fpozzana/Par.Ma/README.md

# Par.Ma


Par.Ma is a 2.5 particulate matter measurement system.

PCB designed for the Electronic systems engineering course at Politecnico di Torino. For further informations on the PCB design refer to the report in the *report* folder.

## Tools

For this project the following tools were used
- OrCAD Capture CIS
- Allegro PCB editor
