fpozzana/Par.Ma/Report/Report.pdf

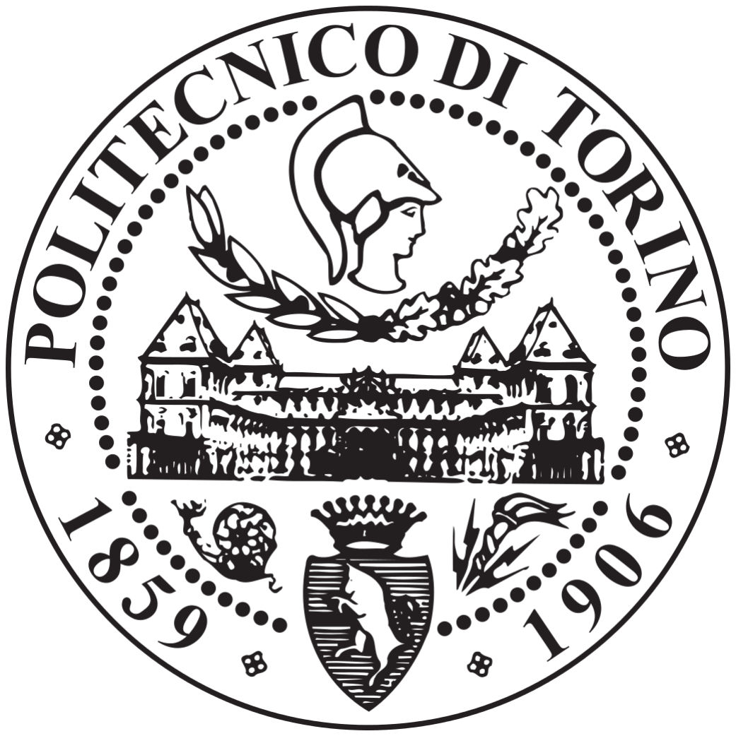
[picture p1: figure]

# Politecnico di Torino

# Electronic systems engineering

# PARticulate MAtter monitoring system

## Technical report

Federico Pozzana, 254758
Professor Eros Pasero

January 12, 2020

## Contents

0 Project specifications | 2
1 Design flow | 2
2 Component selection | 4
3 Schematics | 17
4 Allegro | 22
5 Conclusion | 22

## 0 Project specifications

The PAR.MA. (PARticulate MAtter monitoing system) is a smart particulate matter sensor to measure the concentration of PM2.5 in the environment where it is placed and to report the measurement thanks to the bluetooth technology.
The main specifications of the system are
- PM2.5 accuracy : 10 ug/m3
- Operating temperature : -10 C to 50 C
- Portable form factor
- Rechargeable battery

The main application for this system is to measure the PM2.5 concentration of an open air environment (e.g. main street of a city center), however it can be used inside a home as well. The system is made up of four main blocks, namely

- Power supply : this block is dedicated to the power distribution of the system and the recharge process
- Microprocessor : this block is dedicated to the computational unit of the system; it reads the data coming from the sensor and start the bluetooth communication
- PM2.5 sensor : this block is dedicated to the sensing of the PM2.5 concentration; the communication with the microprocessor is achieved thanks to the UART protocol
- RF module : this block is dedicated to control the PCB antenna

The entire block diagram is shown in the following figure.

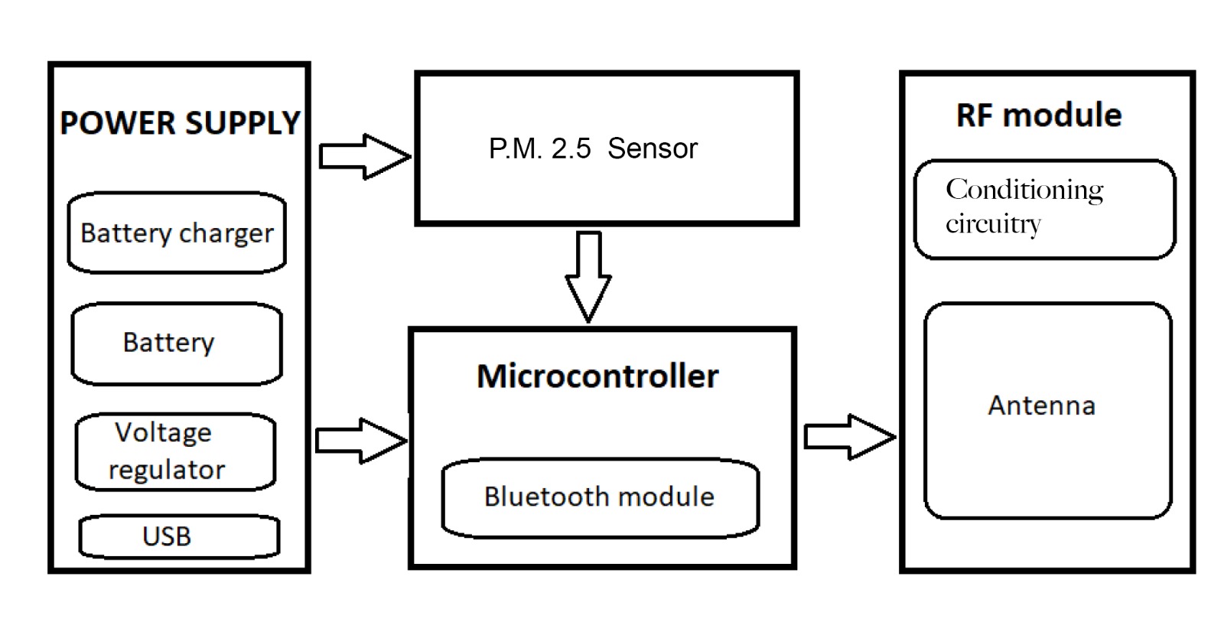
[picture p2: figure]

## 1 Design flow

The design and development of the project followed the step in the table below.

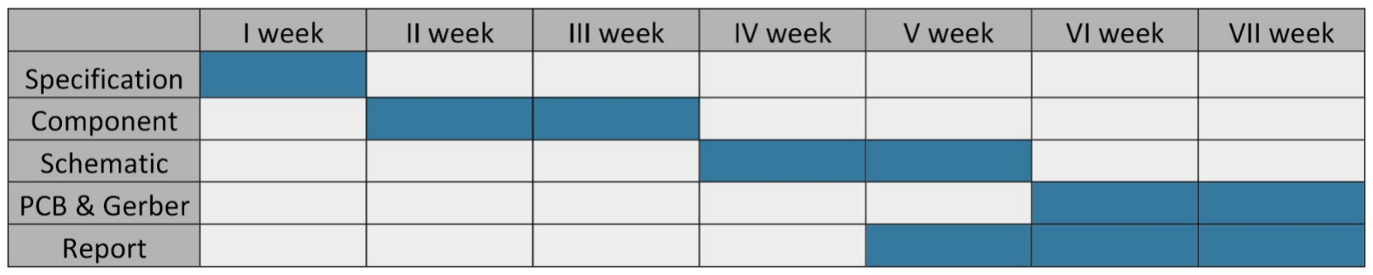
[picture p3: figure]

The following steps were followed in order to complete the system design

- At first the system specifications were defined, the choices in this stage influenced the whole design and the following steps.

- Then the components for the design were chosen according to the initial specifications.
- The schematics were created on ORCAD Capture connecting the components selected in the previous step.
- The PCB was designed according to the manufacturer constraints, the final gerber files were sent to the manufacturer for further checks.
- The technical report was written in order to explain the choices for the system design.

## 2 Component selection

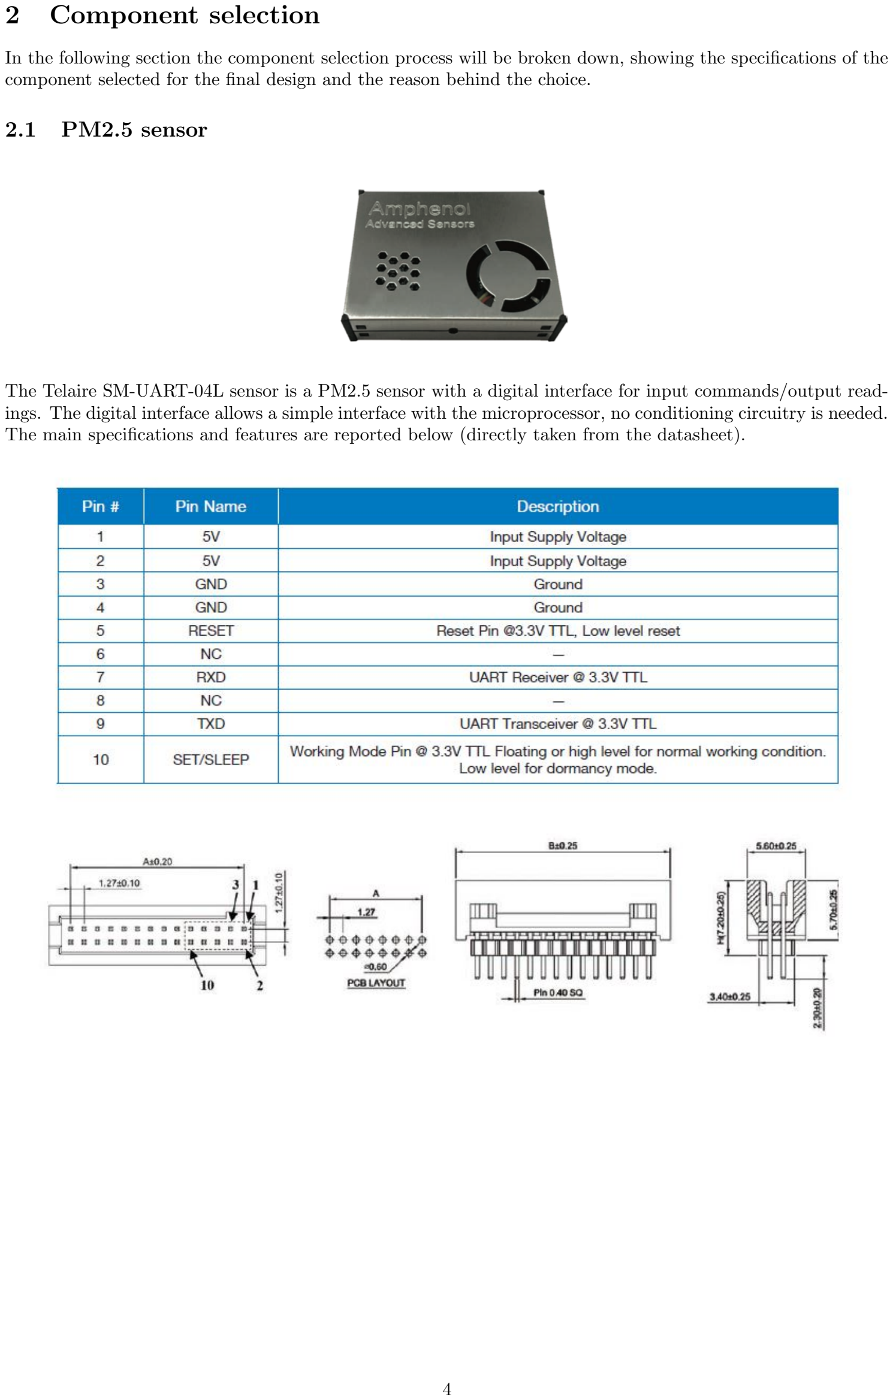
[picture p4: page 5]

In the following section the component selection process will be broken down, showing the specifications of the component selected for the final design and the reason behind the choice.

### 2.1 PM2.5 sensor

The Telaire SM-UART-04L sensor is a PM2.5 sensor with a digital interface for input commands/output read-ings. The digital interface allows a simple interface with the microprocessor, no conditioning circuitry is needed. The main specifications and features are reported below (directly taken from the datasheet).

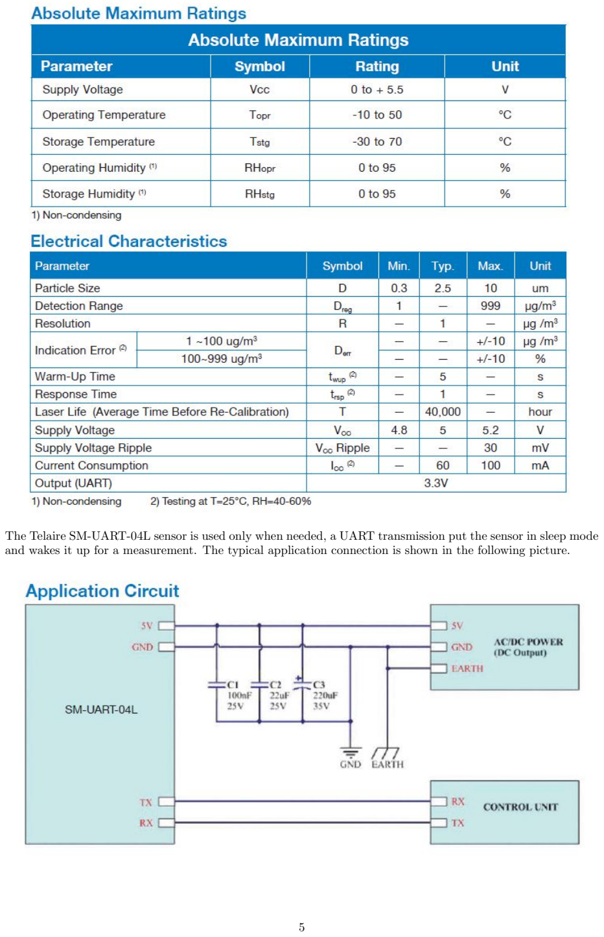
[picture p5: page 6]

The Telaire SM-UART-04L sensor is used only when needed, a UART transmission put the sensor in sleep mode and wakes it up for a measurement. The typical application connection is shown in the following picture.

### 2.2 Microcontroller

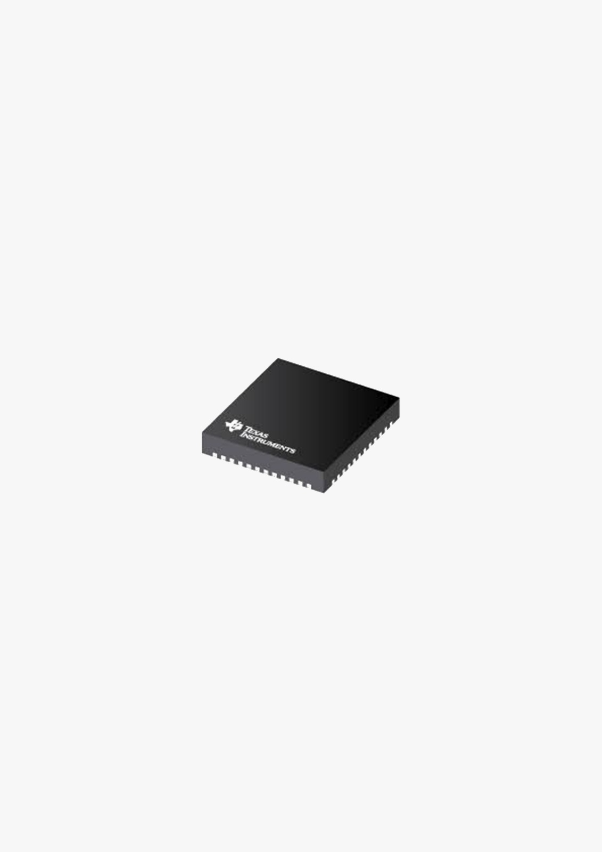
[picture p6: figure]

The choice for the microcontroller unit (MCU) to be used in the project is a fixed requirement; the MCU used is the CC2640R2F from TI. This particular MCU offers both 4.1 and 5.0 Bluetooth connectivity for low energy applications. This particular MCU have a 32-bit ARM Cortex-M3 core, up to 128 Kbytes of flash memory, up to 20 kbytes of SRAM and supports I2C, UART and many more common interfaces. A functional diagram of the MCU is as follows

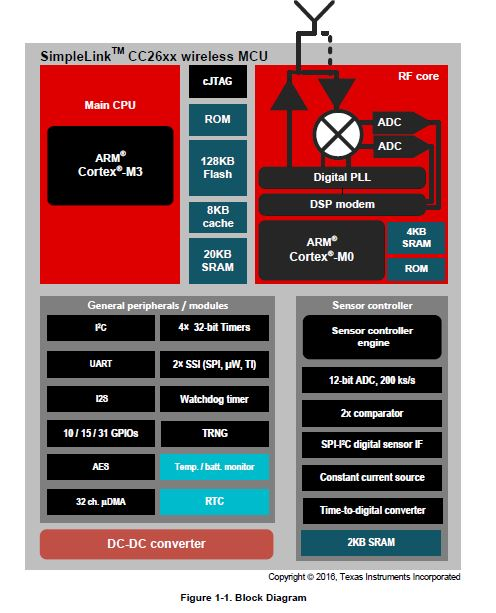
[picture p7: figure]

This MCU is available in different packages, my choice was to employ the 7x7 mm VQFN 48 pins RGZ package for ease of use in case of potentially building the circuit at a different time. The electrical characteristics of the MCU are as follows

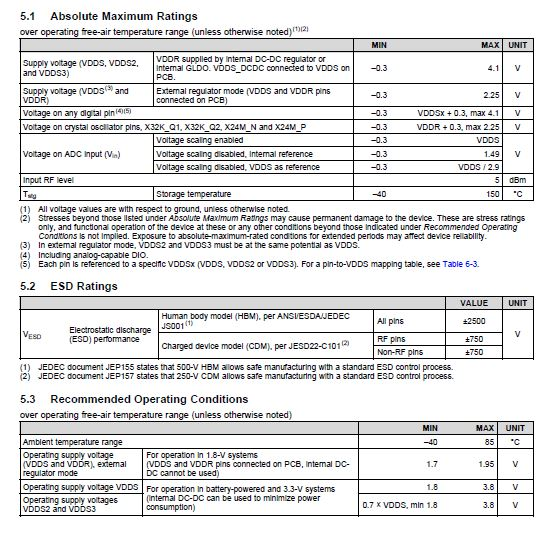
[picture p8: figure]
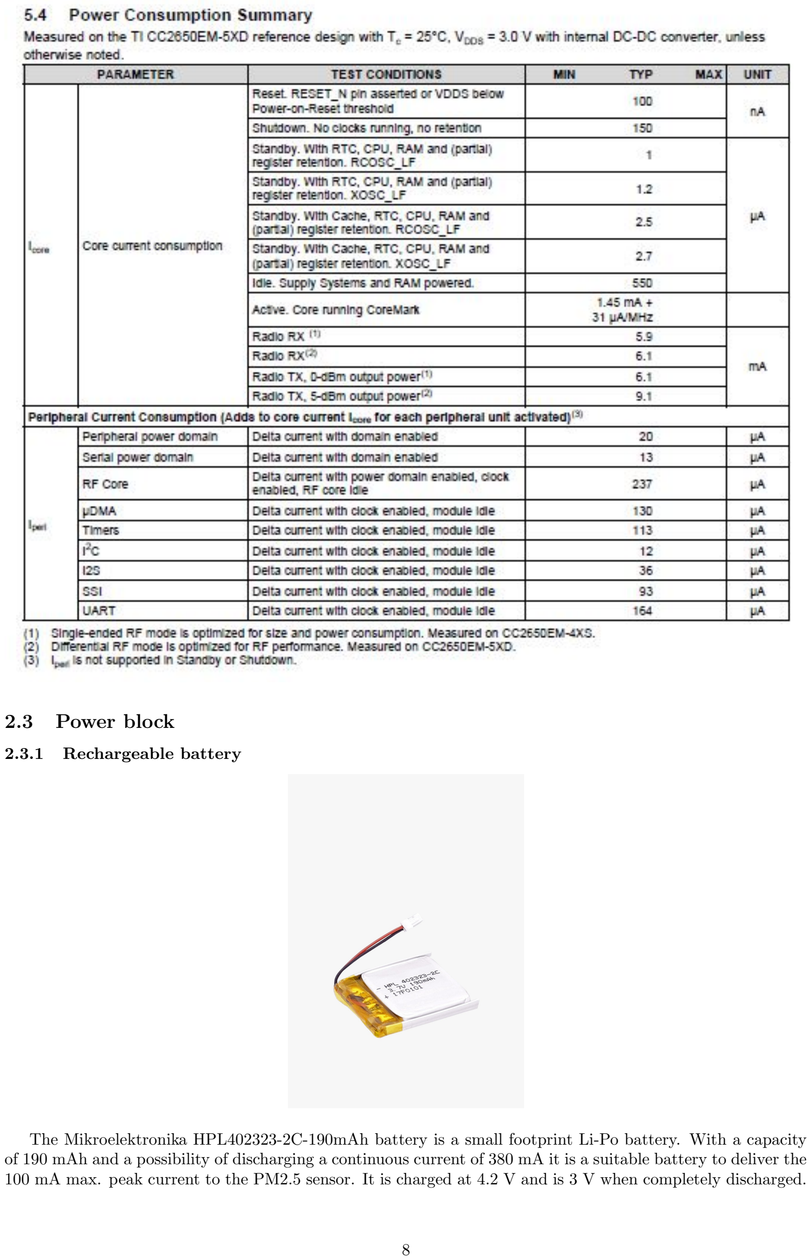
[picture p9: page 9]

### 2.3 Power block

### 2.3.1 Rechargeable battery

The Mikroelektronika HPL402323-2C-190mAh battery is a small footprint Li-Po battery. With a capacity of 190 mAh and a possibility of discharging a continuous current of 380 mA it is a suitable battery to deliver the 100 mA max. peak current to the PM2.5 sensor. It is charged at 4.2 V and is 3 V when completely discharged.

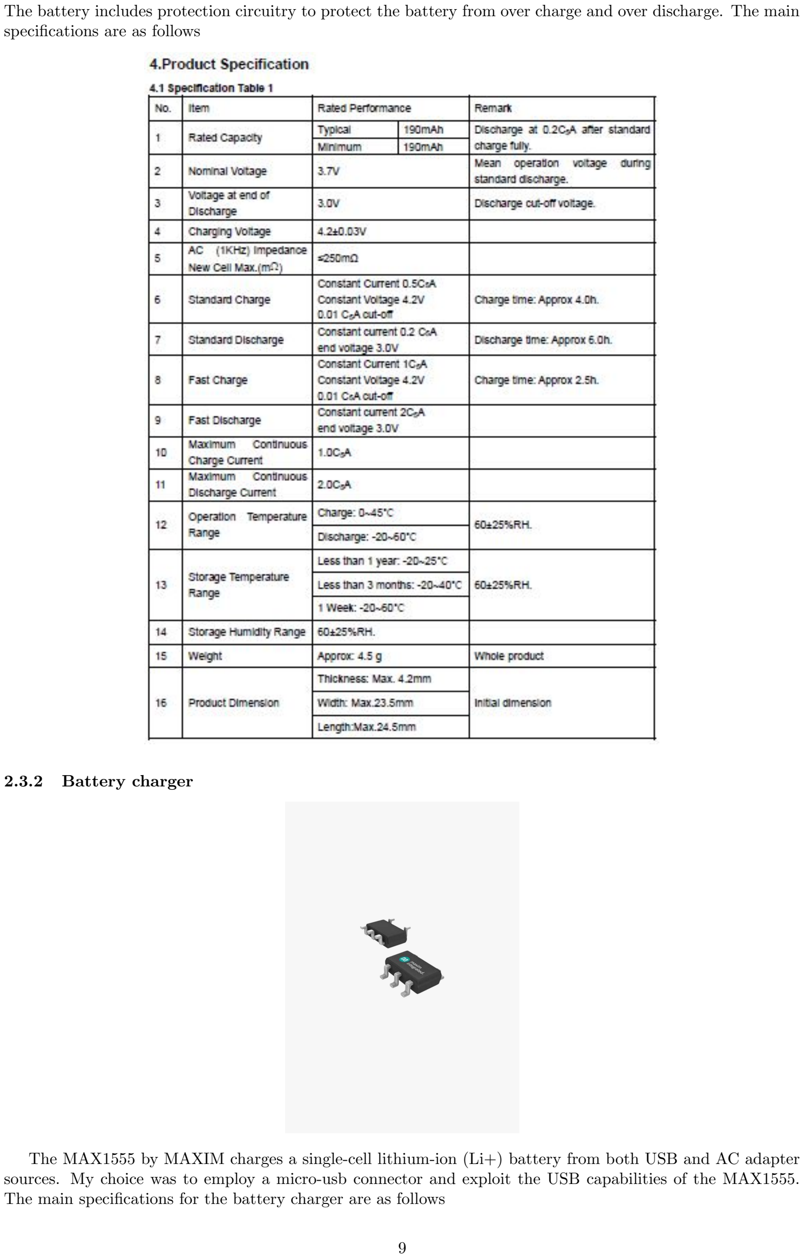
[picture p10: page 10]

The battery includes protection circuitry to protect the battery from over charge and over discharge. The main specifications are as follows

### 2.3.2 Battery charger

The MAX1555 by MAXIM charges a single-cell lithium-ion (Li+) battery from both USB and AC adapter sources. My choice was to employ a micro-usb connector and exploit the USB capabilities of the MAX1555. The main specifications for the battery charger are as follows

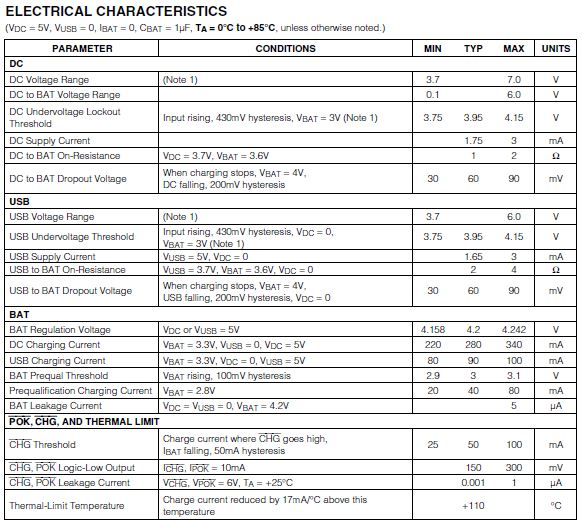
[picture p11: figure]
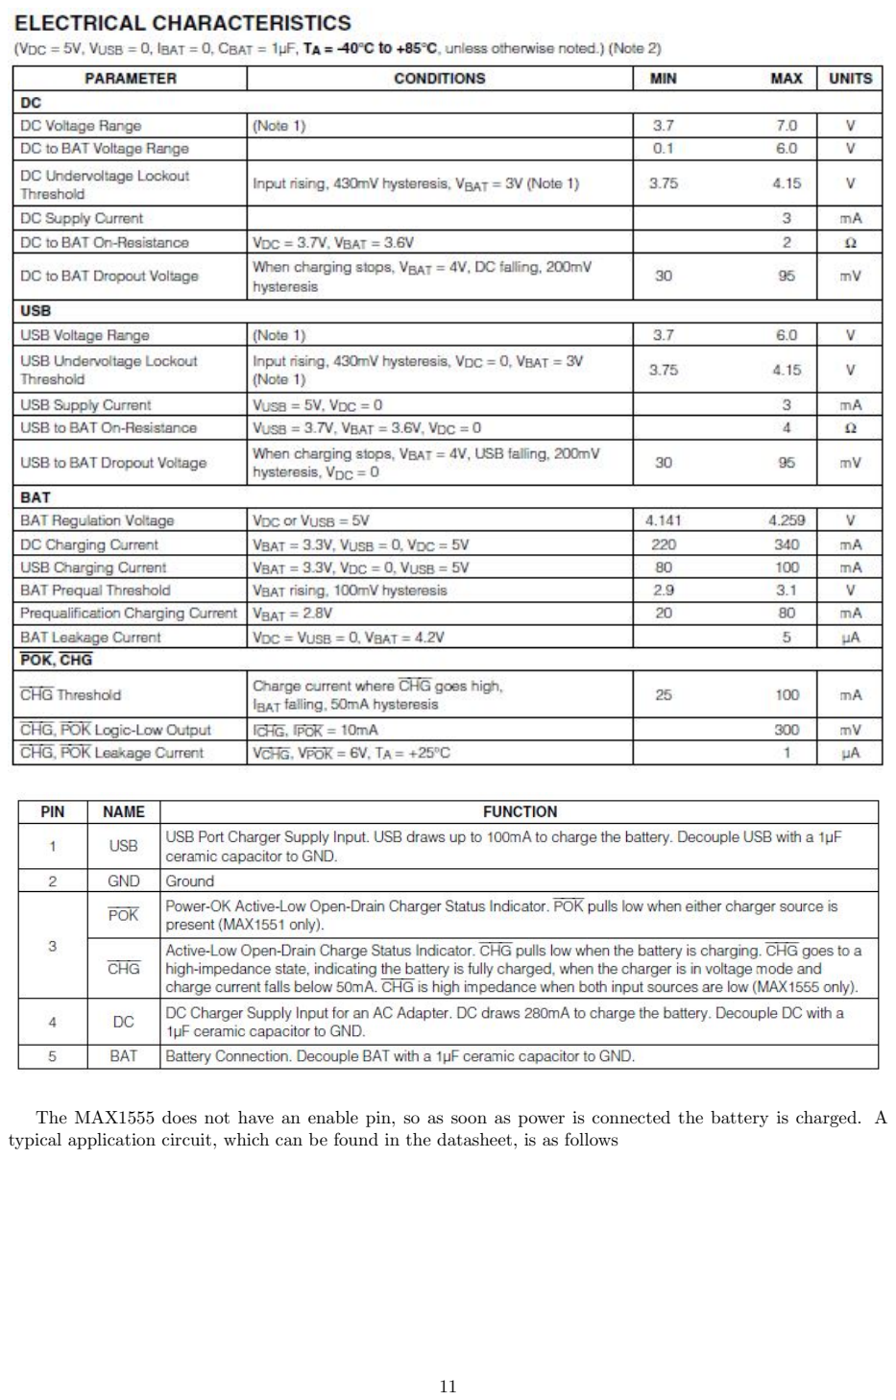
[picture p12: page 12]

The MAX1555 does not have an enable pin, so as soon as power is connected the battery is charged. A typical application circuit, which can be found in the datasheet, is as follows

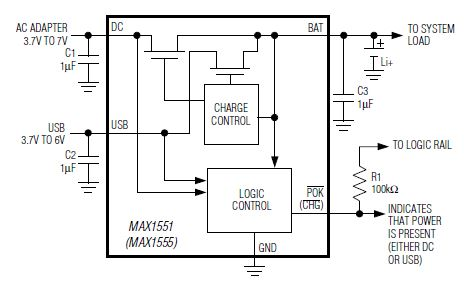
[picture p13: figure]

### 2.3.3 Voltage regulator

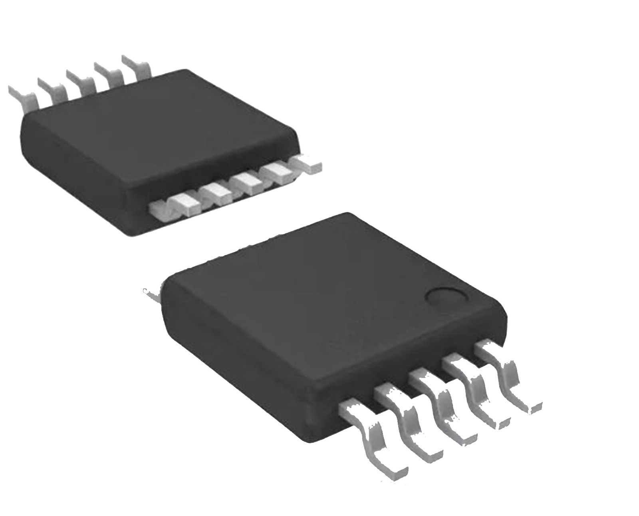
[picture p14: figure]

The MAX1759 by MAXIM is a buck/boost regulating charge pump that generates a regulated output voltage from a single lithium-ion (Li+) cell. The main features for the voltage regulator are as follows

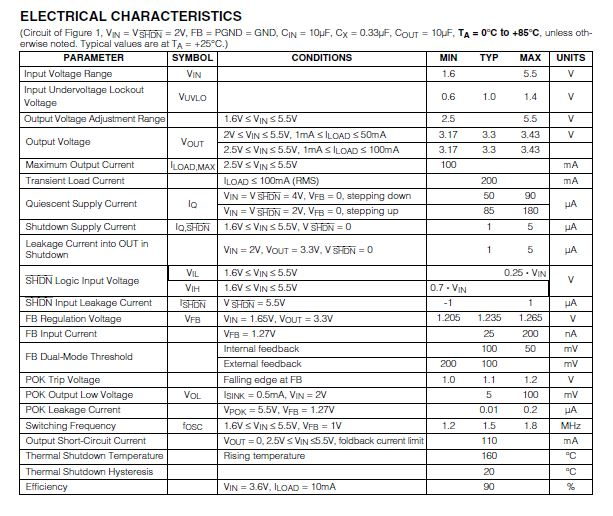
[picture p15: figure]
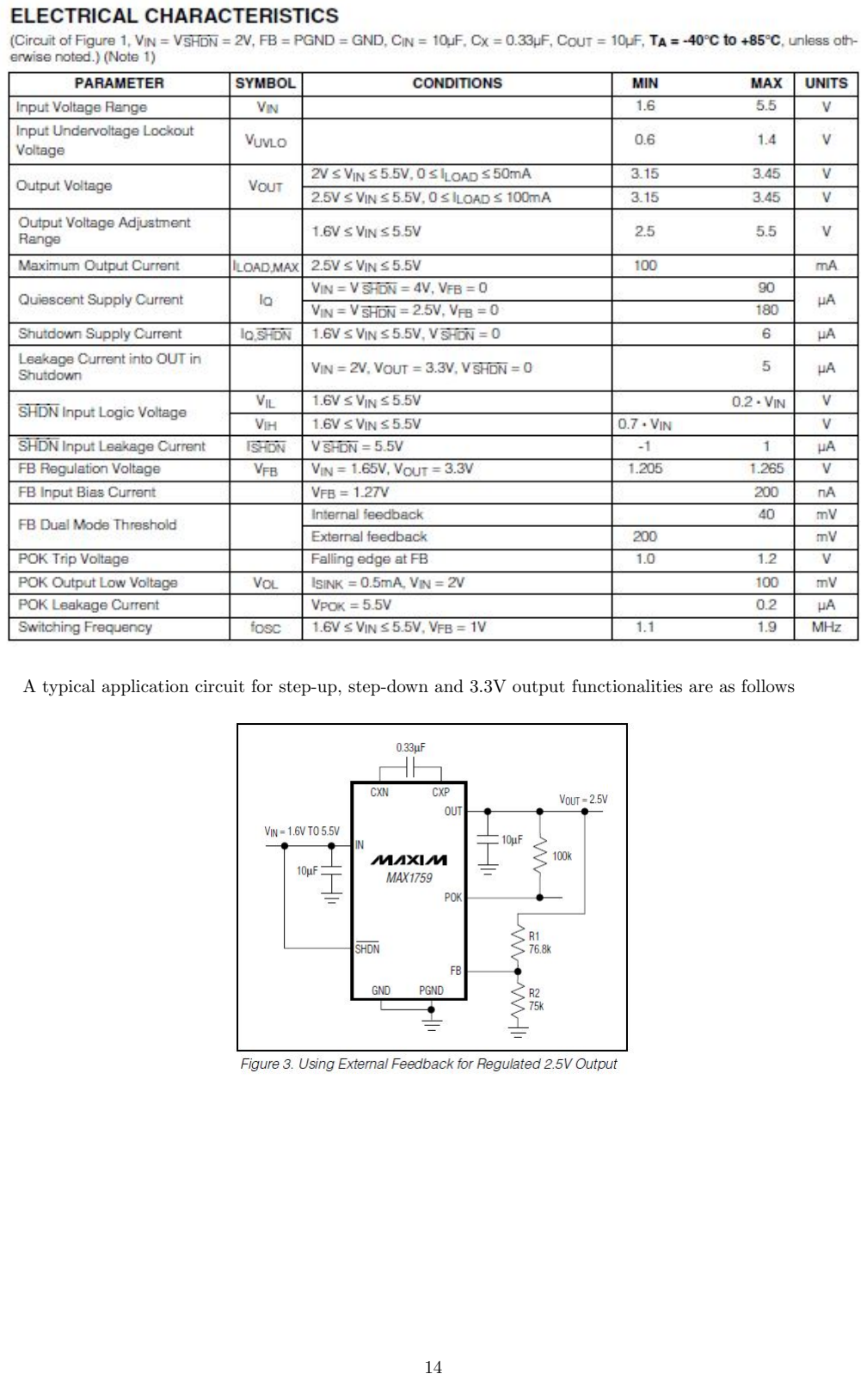
[picture p16: page 15]

A typical application circuit for step-up, step-down and 3.3V output functionalities are as follows

### 2.4 Switch

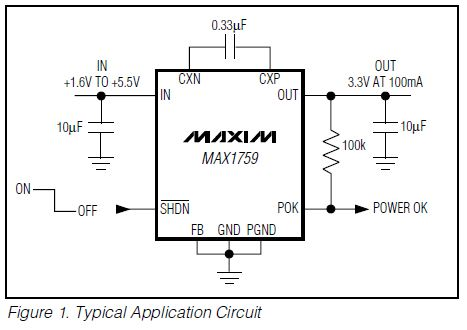
[picture p17: figure]
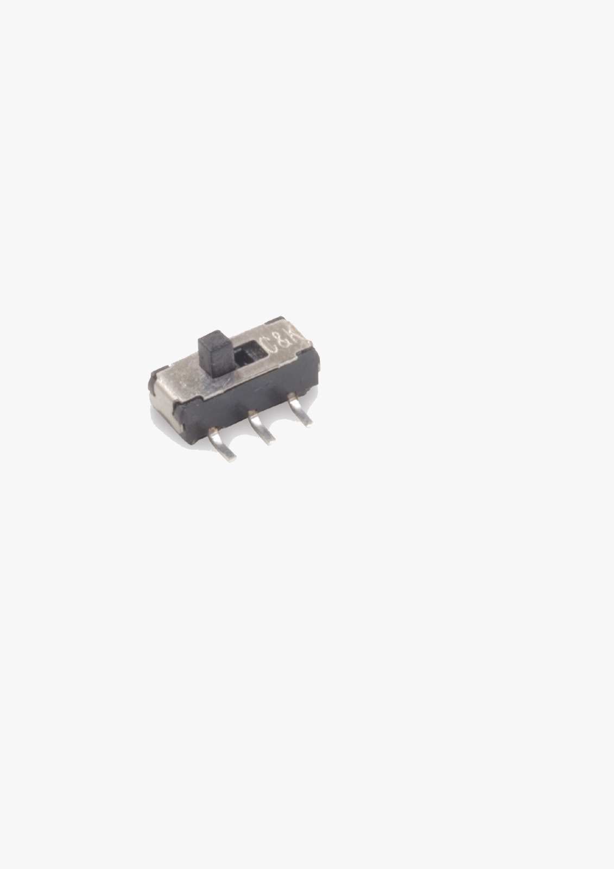
[picture p18: figure]

The JS202011SCQN-DPDT switch has been used. The switch is used to cut off the Li-Po battery from the circuit. The main specifications for the JS202011SCQN-DPDT switch are as follows

### 2.5 LED

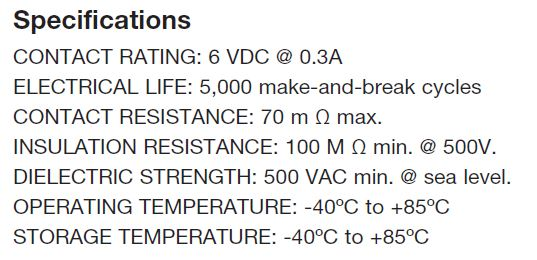
[picture p19: figure]
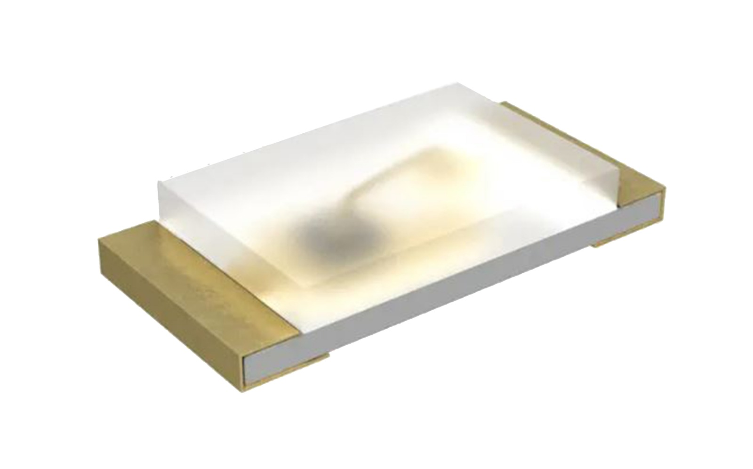
[picture p20: figure]

The APG1608ZGC from Kingbright LED’s are used for the design. Typical applications for this component are status indicator, backlight and wearable and portable devices as stated in the datasheet. The main characteristics for this component are as follows

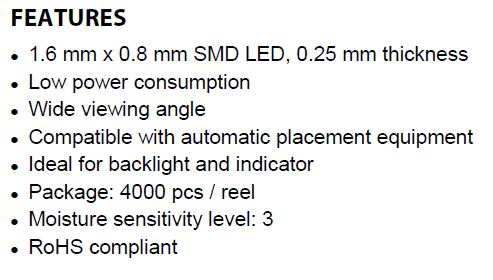
[picture p21: figure]

## 3 Schematics

The schematics for this project are designed using ORCAD Capture. It is possible to identify four possible sections for the PAR.MA. project

- Microcontroller
- Peripherals
- Power
- RF

JTAG_TCKC 25 DIO_16 26 DIO_17 27 DIO_18 28 DIO_19 29 DIO_20 30 DIO_21 31 DIO_22 32 DCDC_SW | 33 VDDS_DCDC | 34 RESET_N | 35 DIO_23 36 DIO_24 37 DIO_25 38 DIO_26 39 DIO_27 40 DIO_28 41 DIO_29 42 DIO_30 43 VDDS 44 VDDR 45 X24M_N 46 X24M_P 47 VDDR_RF 48 EPAD 49

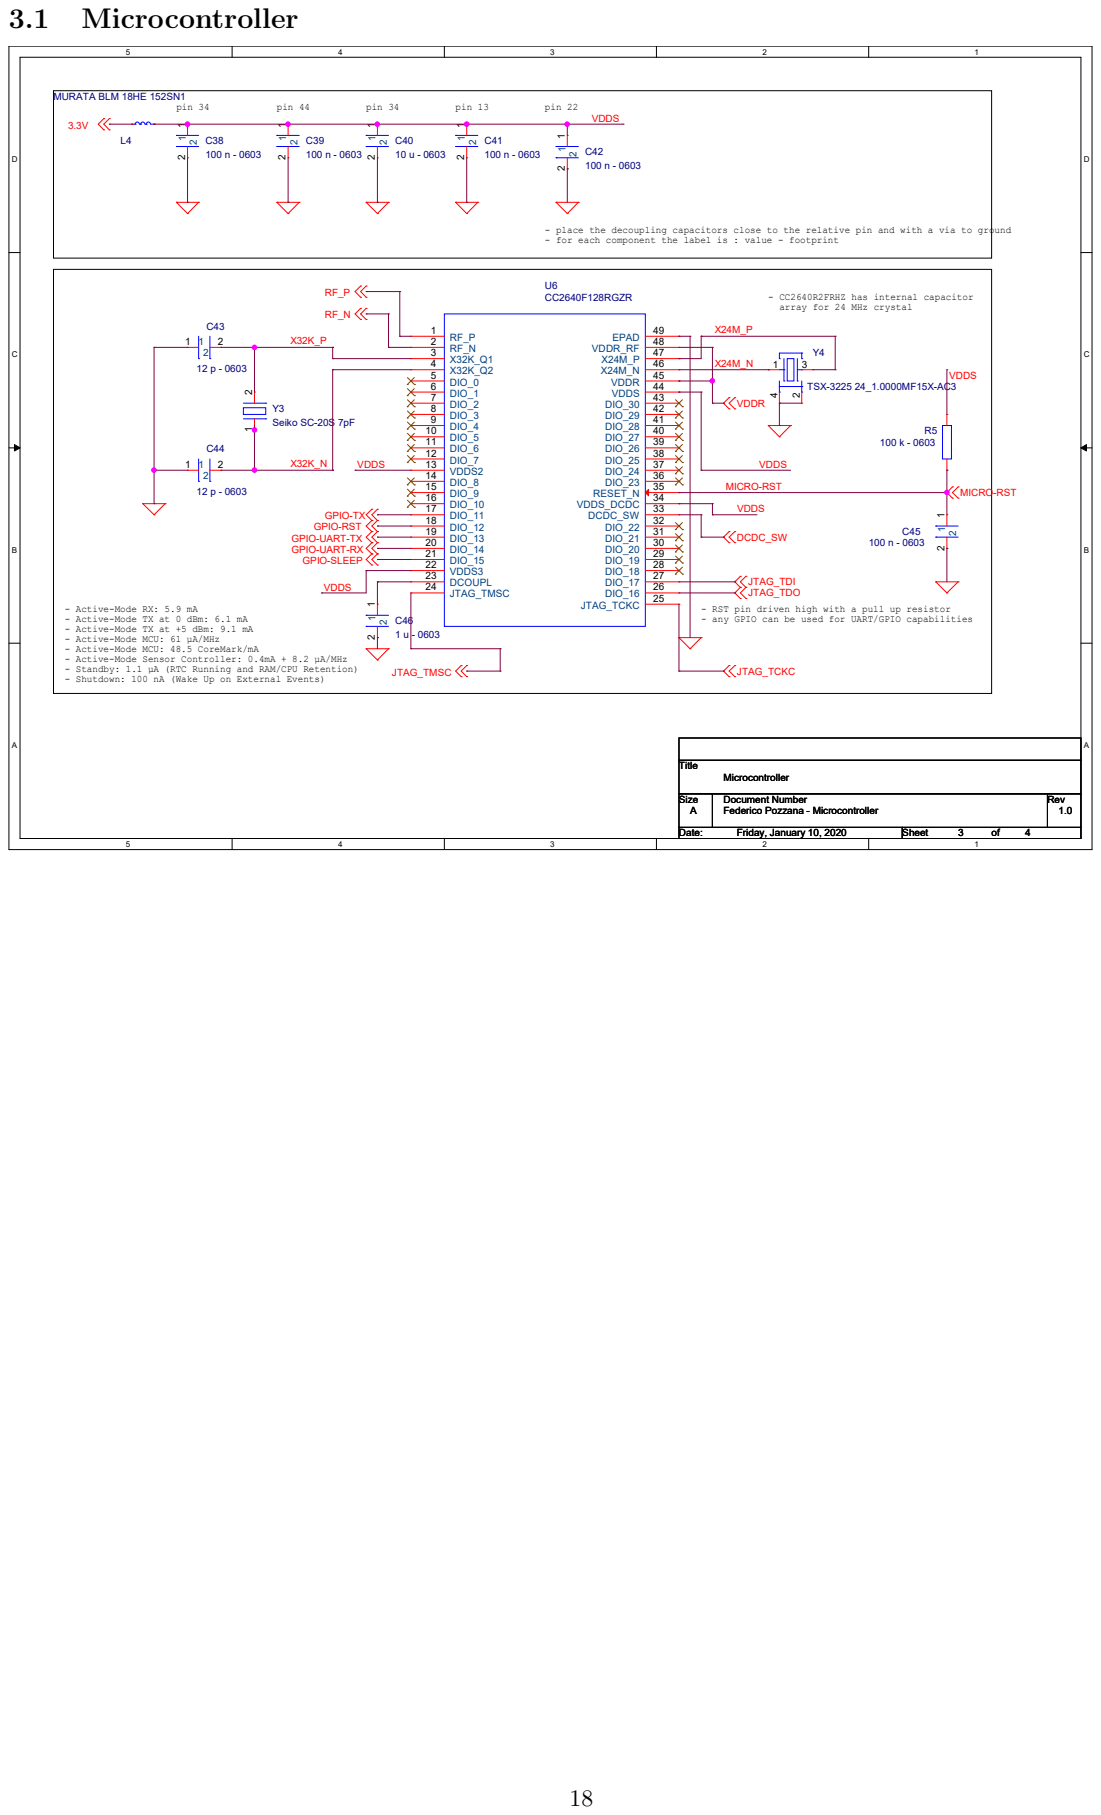
[picture p22: page 19]

pin 34 | pin 44 | | pin 13 | pin 22 pin 34 - place the decoupling capacitors close to the relative pin and with a via to ground - for each component the label is : value - footprint

- CC2640R2FRHZ has internal capacitor
array for 24 MHz crystal

- Active-Mode RX: 5.9 mA
- Active-Mode TX at 0 dBm: 6.1 mA
- Active-Mode TX at +5 dBm: 9.1 mA
- Active-Mode MCU: 61 µA/MHz
- Active-Mode MCU: 48.5 CoreMark/mA
- Active-Mode Sensor Controller: 0.4mA + 8.2 µA/MHz
- Standby: 1.1 µA (RTC Running and RAM/CPU Retention)
- Shutdown: 100 nA (Wake Up on External Events)

- RST pin driven high with a pull up resistor
- any GPIO can be used for UART/GPIO capabilities

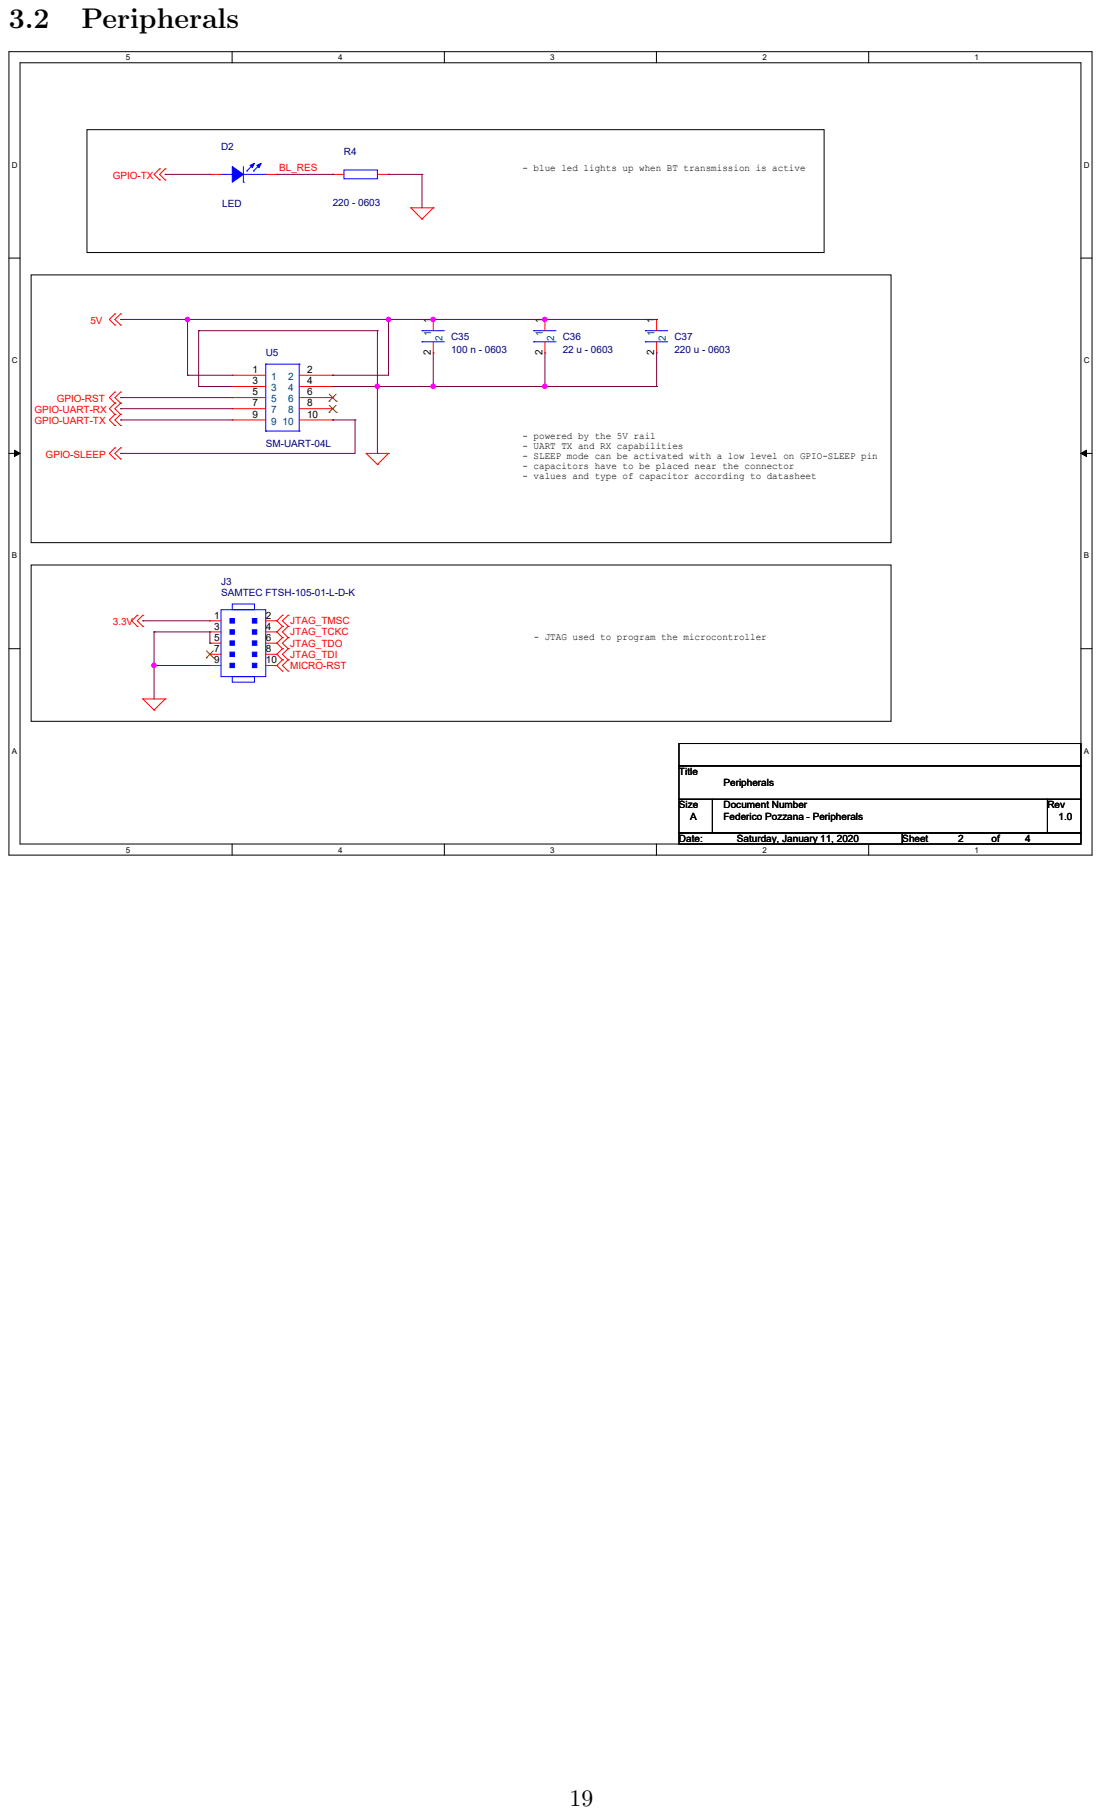
[picture p23: page 20]
3.2 Peripherals; GPIO-TX; GPIO-SLEEP; MICRO-RST; JTAG_TMSC JTAG_TCKC JTAG_TDO JTAG_TDI; Title; Size; Document Number; Rev; Date:; Sheet; Federico Pozzana - Peripherals; Peripherals; Saturday, January 11, 2020; SM-UART-04L; LED; J3 SAMTEC FTSH-105-01-L-D-K; 2 BL_RES

- blue led lights up when BT transmission is active

GPIO-RST
GPIO-UART-RX
GPIO-UART-TX

- powered by the 5V rail
- UART TX and RX capabilities
- SLEEP mode can be activated with a low level on GPIO-SLEEP pin
- capacitors have to be placed near the connector
- values and type of capacitor according to datasheet

- JTAG used to program the microcontroller

### 3.3 Power

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
- MAX-1555 max current during charge is 100 mA
- 1 uF capacitors added according to datasheet specifications
- CHG pin is active low, green led lights up when charging
- DC pin left NC, no further specifications on datasheet
- for each component the label is : value - footprint
- place capacitors within 1 cm of their respective pins
- BAT++ is voltage after the switch
- place bypass capacitors close to MAX1759 pins
- capacitors are ceramic capacitors according to datasheet specifications
- switch used to switch down the entire device
- 3.3V rail used to power up the microcontroller
- for each component the label is : value - footprint
- BAT++ is the voltage after the switch
- place bypass capacitors close to MAX1759 pins
- capacitors are ceramic capacitors according to datasheet specifications
- 5V rail used to power up the PM2.5 sensor
- Actual voltage is 5.2V, which is in the accepted range of the sensor
- Current in the voltage divider is less than 15 uA, as specified in the datasheet
- for each component the label is : value - footprint

5V

3.3V

Title

Size | Document Number | Rev
Date: | Sheet | of
| Federico Pozzana - Power | 1.0

Power

A

Thursday, December 12, 2019 | 1 | 4

Title

Size | Document Number | Rev
Date: | Sheet | of
| Federico Pozzana - Power | 1.0

Power

A

Thursday, December 12, 2019 | 1 | 4

Title

Size | Document Number | Rev
Date: | Sheet | of
| Federico Pozzana - Power | 1.0

Power

A

Thursday, December 12, 2019 | 1 | 4

C8

### 10 uF - 0603

R3

100 K

R2
330 K

J1

BATTERY CONNECTOR

1
2

U3

MAXIM MAX1759

POK 1
SHDN 2
IN1 3
IN2 4
GND 5
FB | 10
OUT | 9
CXP | 8
CXN | 7
PGND | 6

C2

### 1 u - 0603

C7

### 10 uF - 0603

U1

MAXIM MAX1555

USB 1

GND 2

CHG 3

BAT | 5
DC | 4

U4

MAXIM MAX1759

POK 1
SHDN 2
IN1 3
IN2 4
GND 5
FB | 10
OUT | 9
CXP | 8
CXN | 7
PGND | 6
U7 | JS202011SCQN-SWITCH

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
LED - 0603

R1

470 - 0603

MOL1

MOLEX-MICRO USB-CONNECTOR

### 1 VBUS

D- | 2

### 3 D+

4
ID
GND | 5

C3
C4 | 0.33 u - 0603

### 10 uF - 0603

C6
C5 | 0.33 uF - 0603

### 10 uF - 0603

C1

### 1 u - 0603

USB+ | BAT+

GREEN LED

BAT++

CXN

BAT+ | CXP

CHG

BAT++

CXN5V

CXP5V

FB5V

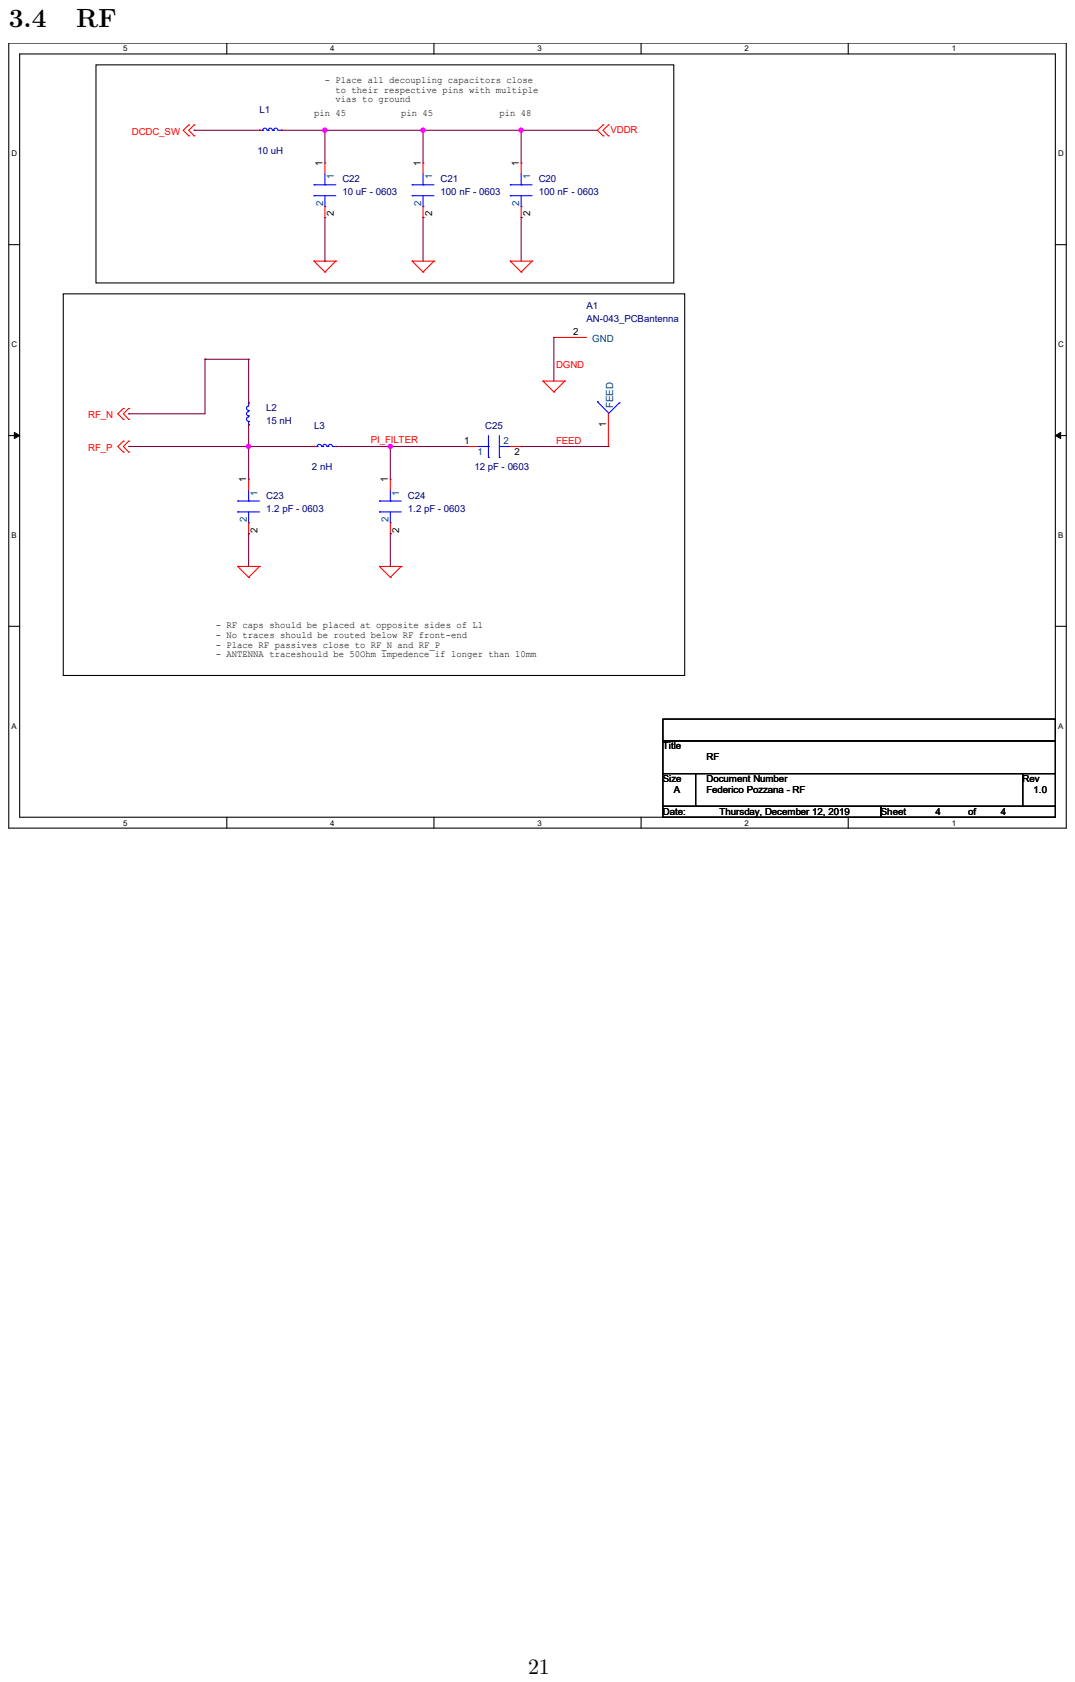
[picture p24: page 22]

- Place all decoupling capacitors close
to their respective pins with multiple
vias to ground

- RF caps should be placed at opposite sides of L1
- No traces should be routed below RF front-end
- Place RF passives close to RF_N and RF_P
- ANTENNA traceshould be 50Ohm impedence if longer than 10mm

### 3.5 Bill of materials

The output below reports the bill of material extracted from the schematic.

## 4 Allegro

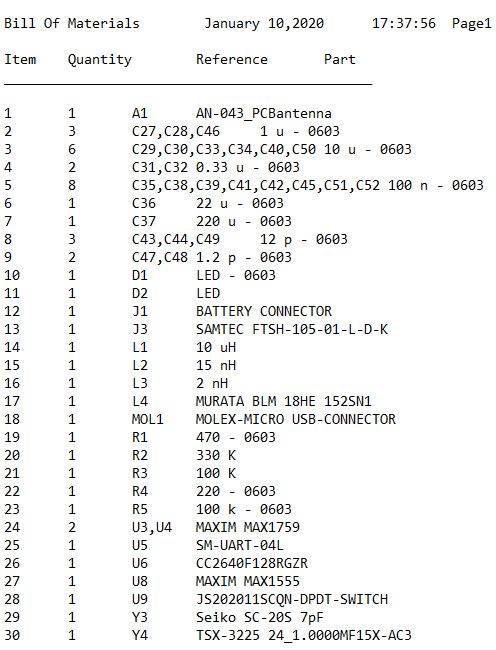
[picture p25: figure]

The top and bottom layer of the PCB are reported in the PCBPROTO.pdf file.
The ground plane is absent below the antenna in order to avoid interferences during transmission and reception in that particular direction. All the decoupling and bypass capacitors were placed as close as possible to the respective pins.The bottom layer is reserved to the ground plane and some traces that couldn’t be routed in the top layer.

## 5 Conclusion

The project is ready to be manufactured, however the goal for this project is to deliver the gerber files without building it. For this reason no app and firmware are going to be developed.
