fpozzana/Par.Ma/(list of files, cad)

Other CAD files:
FOOTPRINTS/0603_l.psm
FOOTPRINTS/an043_flip.psm
FOOTPRINTS/apg1608zgc-smd-led.psm
FOOTPRINTS/c_0603.psm
FOOTPRINTS/cc2640rgz.psm
FOOTPRINTS/con00906_5.psm
FOOTPRINTS/conn_jst_sm02b-srss.psm
FOOTPRINTS/js202011scqn-dpdt.psm
FOOTPRINTS/jtagfootprint.psm
FOOTPRINTS/r_0603.psm
FOOTPRINTS/sc-20s.psm
FOOTPRINTS/sm-uart-04l.psm
FOOTPRINTS/smd_max1555.psm
FOOTPRINTS/smd_max1759.psm
FOOTPRINTS/tsx-3225.psm
