fpozzana/Par.Ma/(list of files, drawings)

Other design files:
Orcad/PARTICULATEMATTER.DSN
Orcad/PARticulateMAtter.opj
