fpozzana/Par.Ma/Orcad/allegro/art_param.txt

DEVICE-TYPE           GERBER_RS274X
OUTPUT-UNITS          MM
FILM-SIZE             4000000 10000000
FORMAT                2.5
ABORT-ON-ERROR        NO
SCALE                 1
SUPPRESS-LEAD-ZEROES  YES
SUPPRESS-TRAIL-ZEROES NO
SUPPRESS-EQUAL        YES
UNDEF-APT-CONT        NO
